kennywakaba/IGEN-430-Minesweeper/mainboard.step

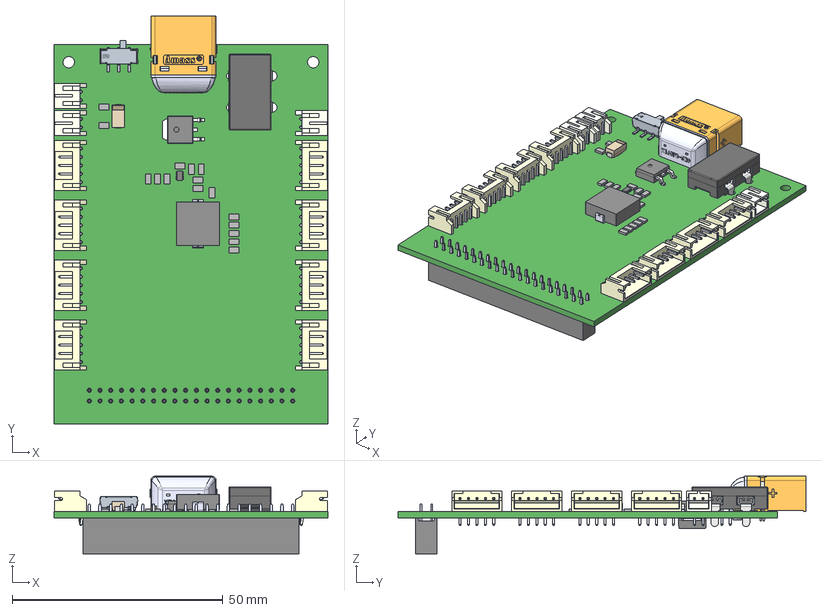
[picture p1: CAD file, 2024-03-06]
mainboard.step
65.0 x 96.8 x 18.5 mm
Extruded x 16
JS102011SAQN--3DModel-Eagle-1
DPAK x 2
keystone-PN3549-2
User Library-XT60PW 3D DRAWING_XT60____-8______-UL-21156
User Library-XT60PW 3D DRAWING_XT60____-8____-21157 x 2
User Library-XT60PW 3D DRAWING_XT60____-8________ x 2
User Library-XT60PW 3D DRAWING_XT60PW-M20____-8-UL
2 row tin body_20
2 row tin pins x 20
