kennywakaba/IGEN-430-Minesweeper/Project Outputs for minesweeper-mainboard/jlc-fabrication.PDF

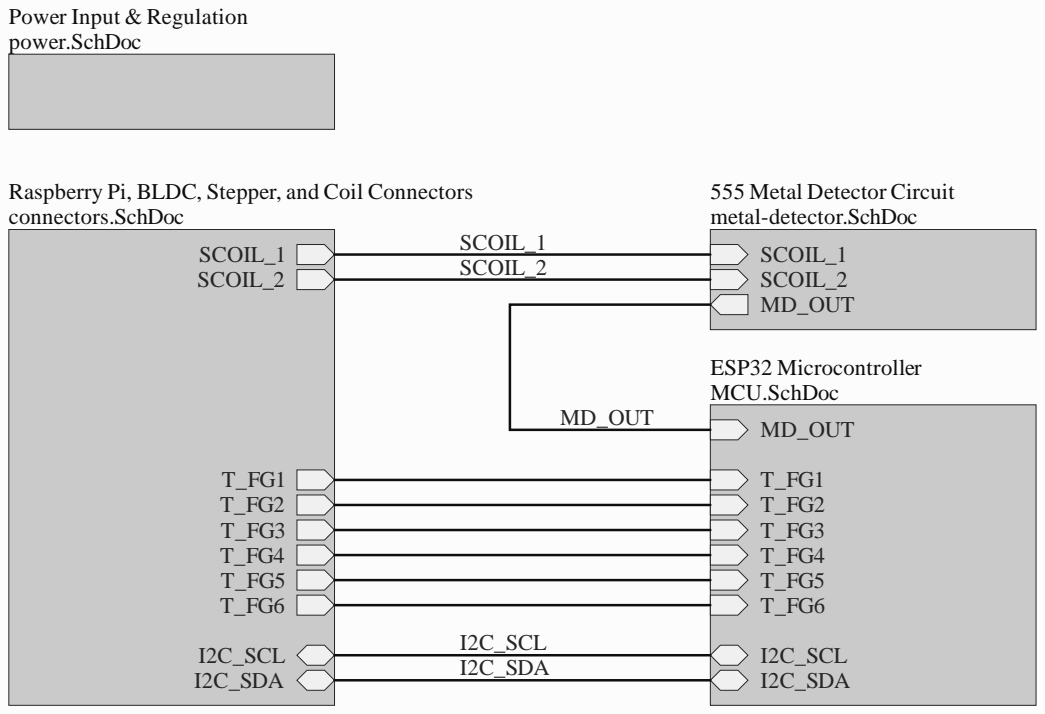
[picture p2: page 1]

Raspberry Pi, BLDC, Stepper, and Coil Connectors
connectors.SchDoc

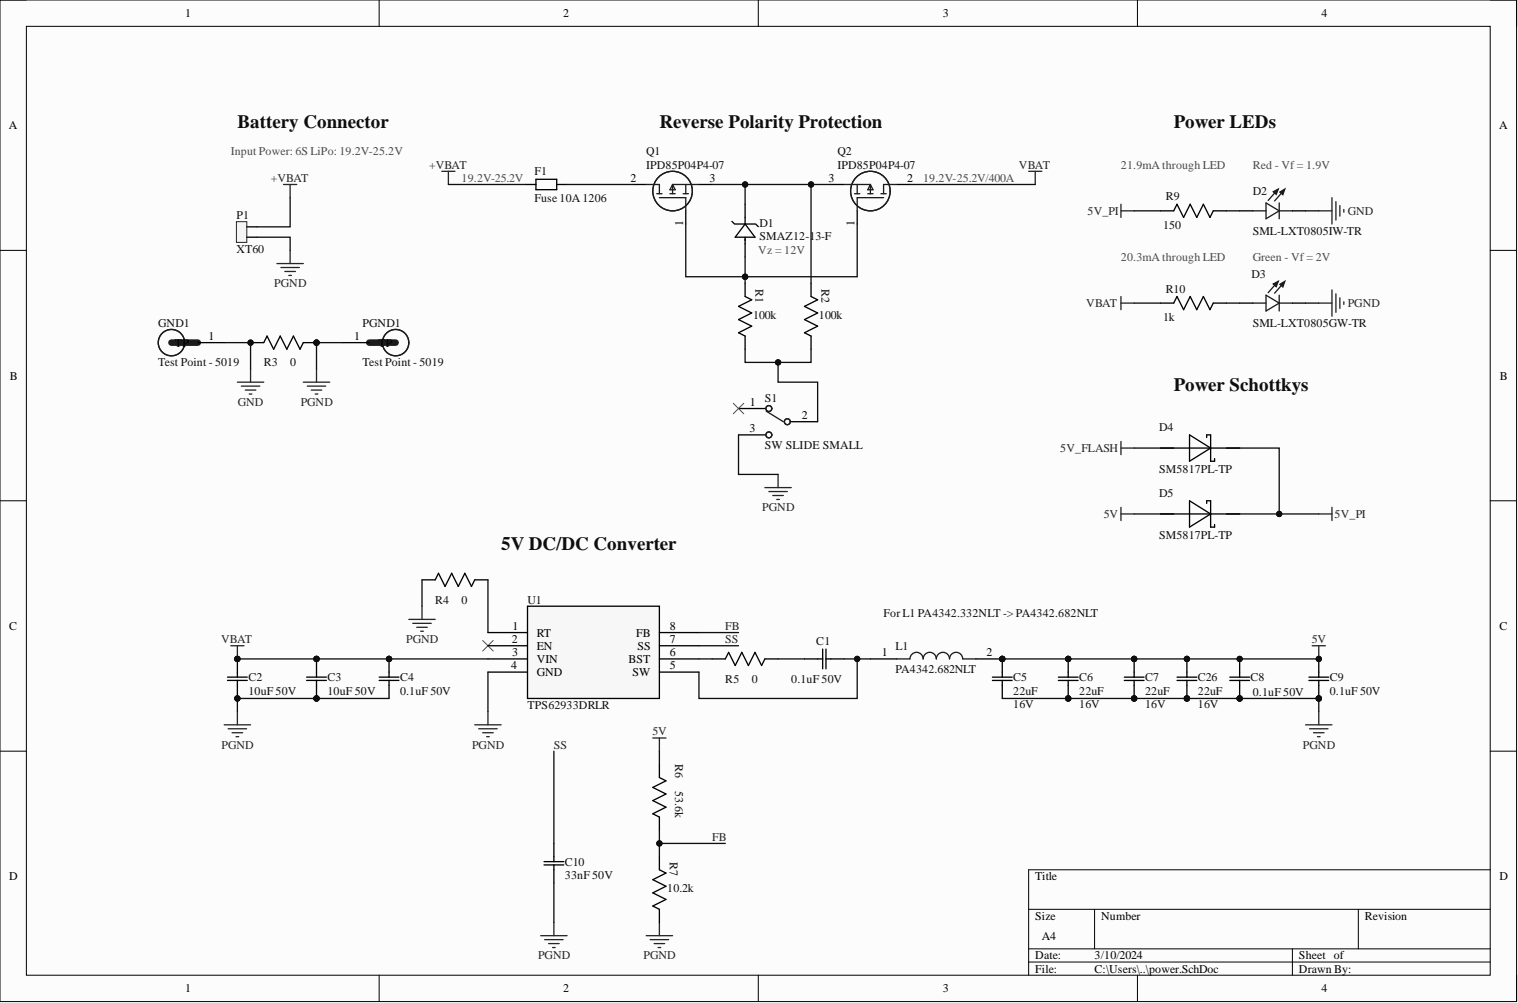
[picture p3: page 2]

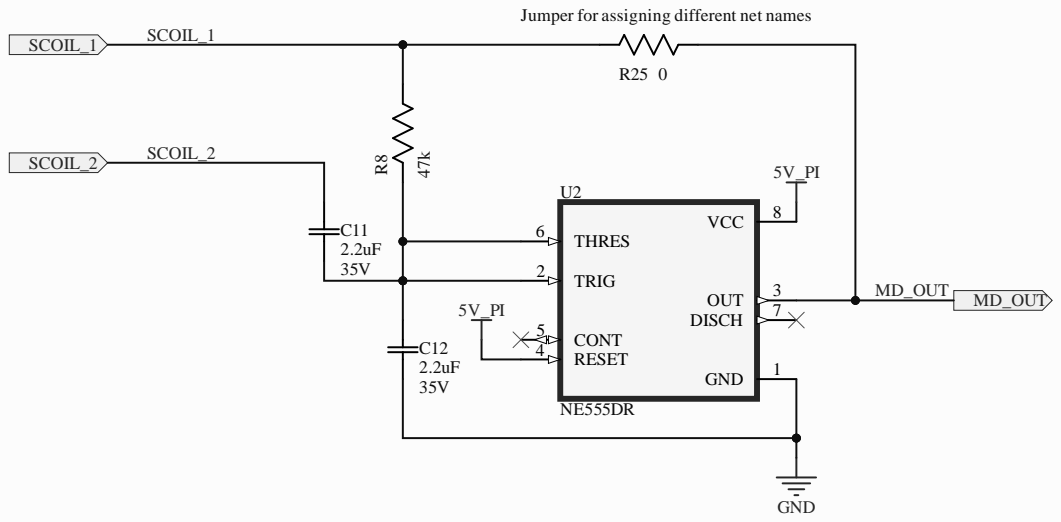
[picture p4: page 3]

DISC CO N T RESE T | H

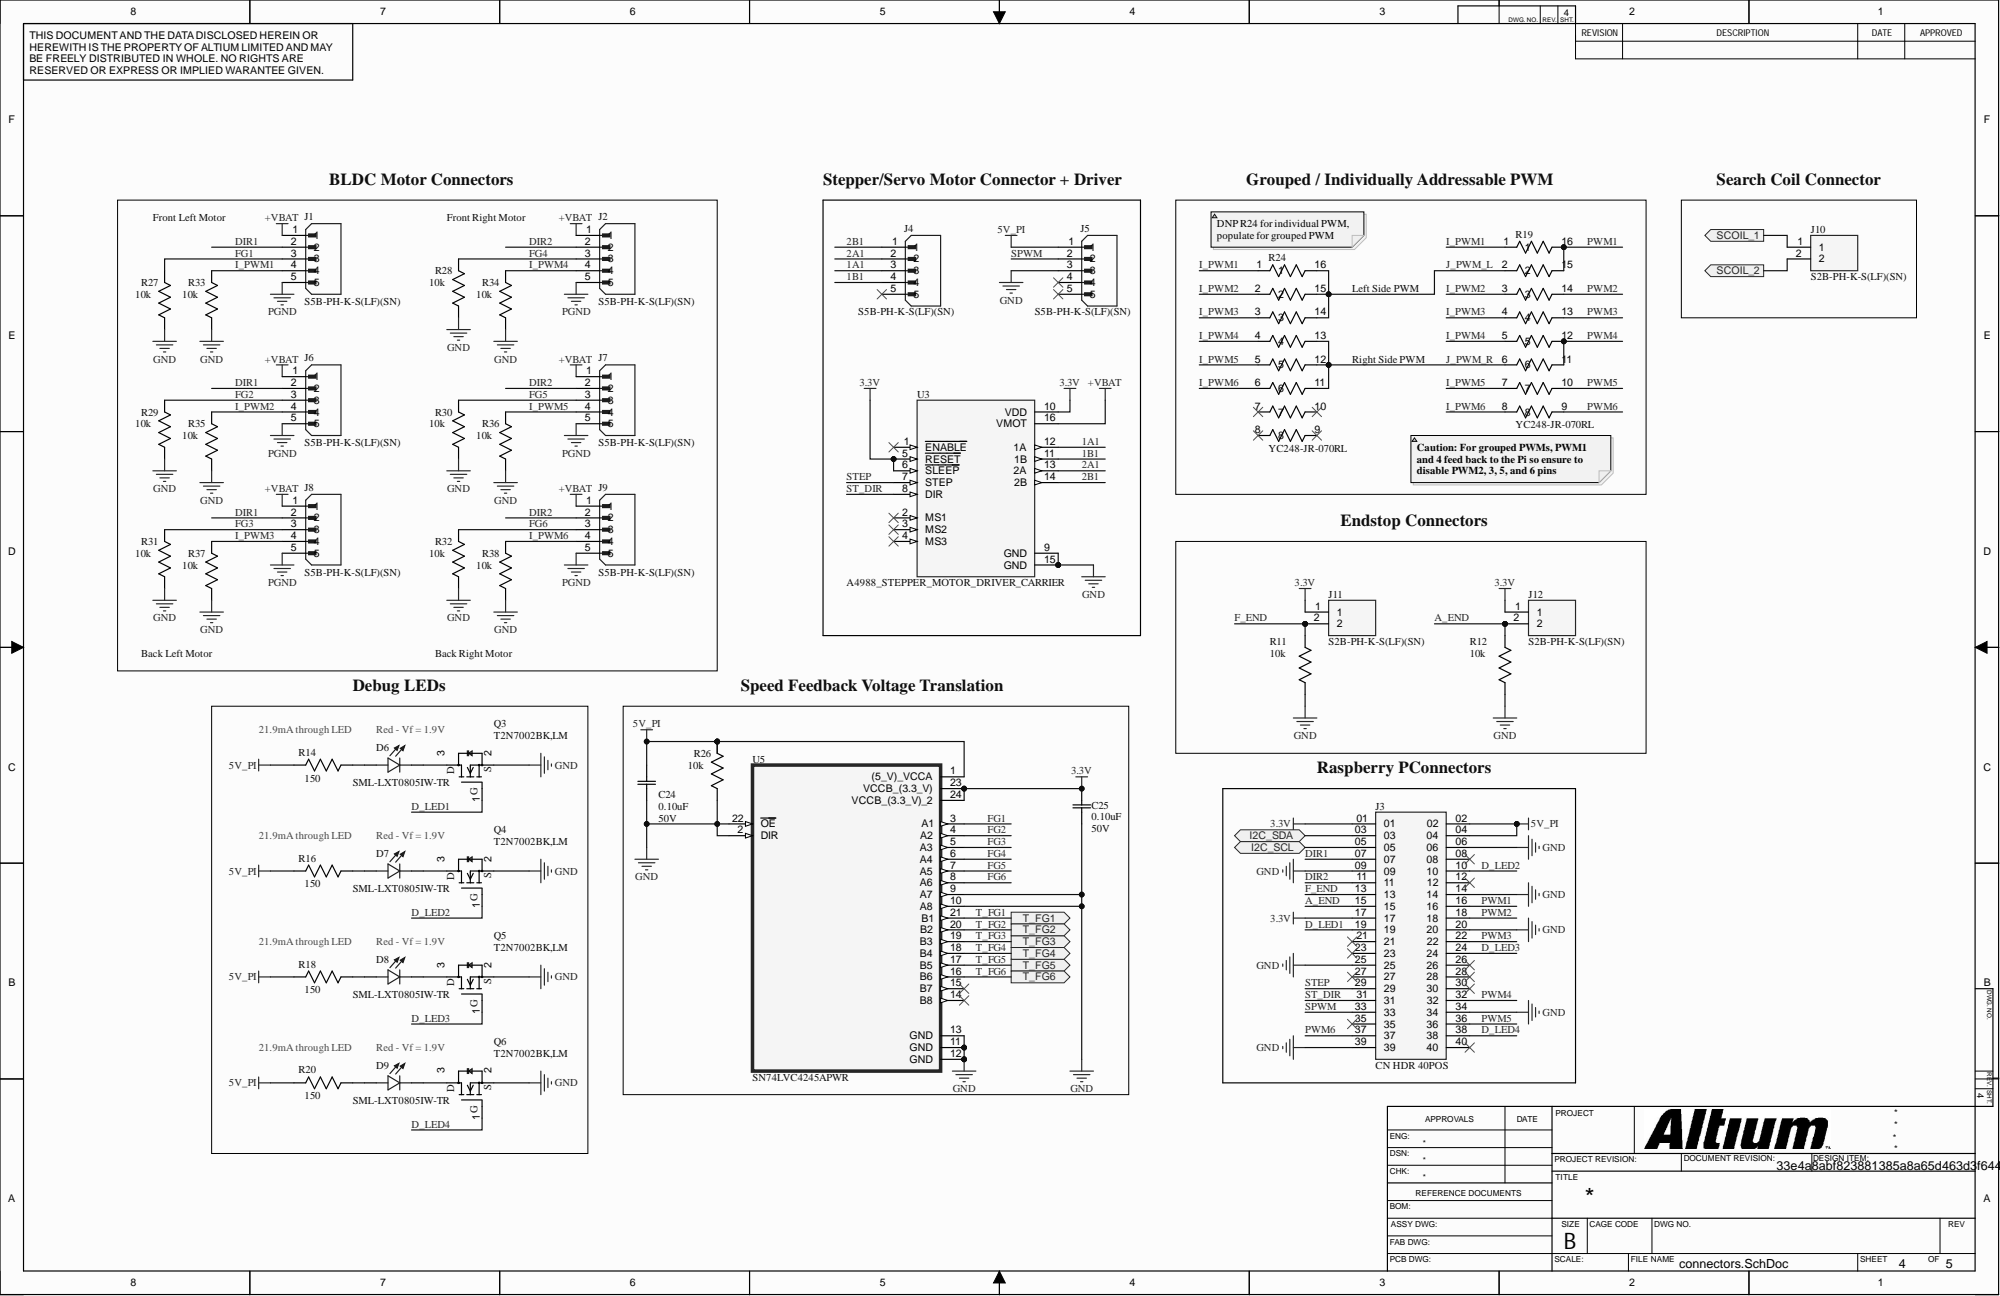
[picture p5: page 4]

DWG . N O . | R E V . | S H T.

T H IS DOC U MEN T AN T HE ATA ISCLOSED HEREI N OR HEREW I T H IS T HE PROPER TY OF ALT I U M LI M I TED AN M AY BE F REELY IST R IBU TED I N W HOLE. NO R IGH TS ARE RESERVED OR EXPRESS OR I MPLIED WARAN TEE GIVEN . BLDC Moto | r Connectors Stepper/Serv o Moto r Connecto r + Driver G r ouped / Individually Addressable PWM | REVISI ON | DESCRIPTI O N | DATE | APPROVED

REV. SHT. DWG. NO.

DATE | PRO JECT | **** APPROVALS

ENG :
** DSN:

CHK: *

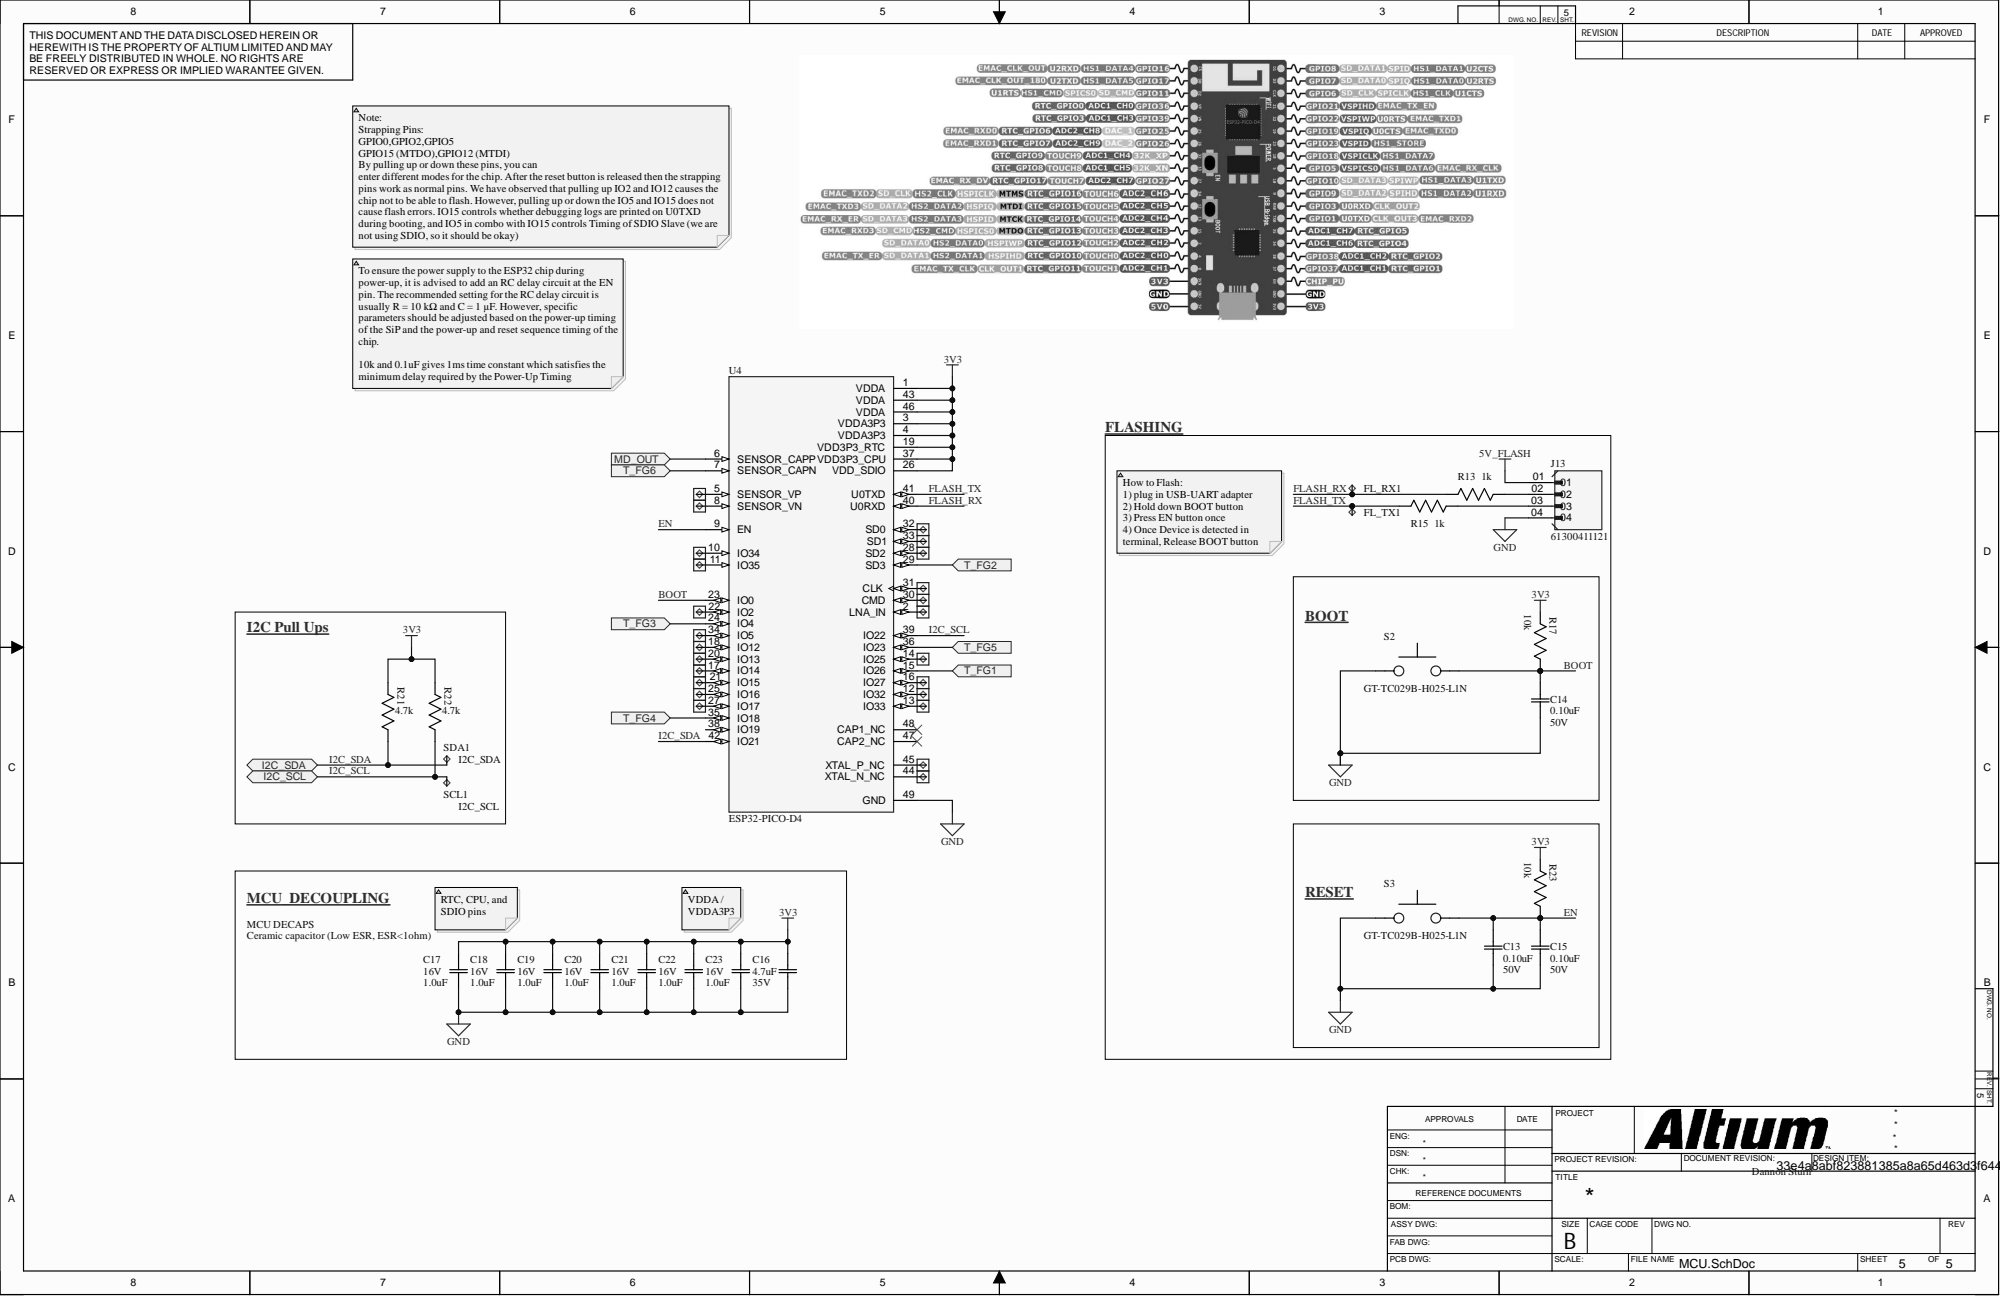
[picture p6: page 5]

DWG . N O . | R E V . | S H T.

T H IS DOC U MEN T AN T HE ATA ISCLOSED HEREI N OR HEREW I T H IS T HE PROPER TY OF ALT I U M LI M I TED AN M AY BE F REELY IST R IBU TED I N W HOLE. NO R IGH TS ARE RESERVED OR EXPRESS OR I MPLIED WARAN TEE GIVEN . | 3 V | REVISI ON | DESCRIPTI O N | DATE | APPROVED

of SDIO Slave (we are

REV. SHT. DWG. NO.

DATE | PRO JECT | **** APPROVALS

ENG :
** DSN:

CHK: *
