kennywakaba/IGEN-430-Minesweeper/simulation/SMAZ12 - Reverse Polarity Protection Circuit/SMAZ12 - Reverse Polarity Protection Circuit.asc

M1: pmos
M2: pmos
R1: res; 100k
R2: res; 100k
R3: res; 1k
U1: SMAZ12
V1: voltage; 23.7
Named nets: 0, VZ+, VZ-
.tran 40u startup
.lib C:\\Users\\kenny\\Downloads\\Zener Diodes.spice.txt
.SUBCKT SMAZ12  1 2
*        Terminals    A   K
D1 1 2 DF
DZ 3 1 DR
VZ 2 3 11.2
.MODEL DF D ( IS=2.51p RS=.0780 N=1.15
+ CJO=100p VJ=0.750 M=0.330 TT=50.1n )
.MODEL DR D ( IS=5.02f RS=0.65 N=1 )
.ENDS
.SIMULATOR DEFAULT
