kennywakaba/IGEN-430-Minesweeper/(list of files, drawings)

Other design files:
components/826949-4/826949-4.PcbLib
components/826949-4/826949-4.SchLib
components/61300411121/61300411121.SchLib
components/61300411121/WURTH_61300411121.PcbLib
components/GT-TC029B-H025-L1N/GT-TC029B-H025-L1N.SchLib
components/NE555DR/NE555DR.SchLib
components/NE555DR/SOIC127P599X175-8N.PcbLib
components/S5B-PH-K-S_LF__SN_/JST_S5B-PH-K-S(LF)(SN).PcbLib
components/S5B-PH-K-S_LF__SN_/Project Outputs for S5B-PH-K-S_LF__SN_/S5B-PH-K-S_LF__SN_/JST_S5B-PH-K-S(LF)(SN).PcbLib
components/S5B-PH-K-S_LF__SN_/Project Outputs for S5B-PH-K-S_LF__SN_/S5B-PH-K-S_LF__SN_/S5B-PH-K-S(LF)(SN).SchLib
components/S5B-PH-K-S_LF__SN_/S5B-PH-K-S(LF)(SN).SchLib
connectors.SchDoc
mainboard.PcbDoc
MCU.SchDoc
metal-detector.SchDoc
minesweeper-mainboard.PrjPcb
power.SchDoc
root.SchDoc
simulation/SMAZ12 - Reverse Polarity Protection Circuit/TPS62932_TRANS.DSN
simulation/SMAZ12 - Reverse Polarity Protection Circuit/TPS62932_TRANS.opj
simulation/SMAZ12 - Reverse Polarity Protection Circuit/TPS62932DRL_TRANS.OLB
