kennywakaba/IGEN-430-Minesweeper/(commit log)

2024-01-18 added root and power schematics
    [minesweeper-mainboard.PrjPcb, power.SchDoc, root.SchDoc]
2024-02-01 added databases and intlib for converter IC. Still need to find footprint for the inductor
    [power.SchDoc]
2024-02-05 completed most of the schematics, waiting on Software regarding Raspberry Pi pinouts and final revision before layout
    [mainboard.PcbDoc, metal-detector.SchDoc, minesweeper-mainboard.PrjPcb, power.SchDoc, root.SchDoc]
2024-02-07 forgot to add connector.SchDoc lol
    [connectors.SchDoc]
2024-03-01 added component folder, layout WIP almost complete, schematic needs an update, look into connectors for endstops
    [connectors.SchDoc, mainboard.PcbDoc, mainboard.step, minesweeper-mainboard.PrjPcb, power.SchDoc]
2024-03-02 added LED circuits, TODO: add 2 pin JSTs, find 5 pin JSTs with preassembled cables, look into ESP32 options
    [mainboard.PcbDoc, power.SchDoc]
2024-03-03 changed connectors to JSTs, added MCU schematic. TODO: add a thermal relief layout, add voltage translater, figure out ESP32 pinouts
    [826949-4.PcbLib, 826949-4.SchLib, MCU.SchDoc, connectors.SchDoc, mainboard.PcbDoc, minesweeper-mainboard.PrjPcb, root.SchDoc]
2024-03-06 added new MCU schematic: WIP
    [MCU.SchDoc, connectors.SchDoc, mainboard.PcbDoc, mainboard.step, minesweeper-mainboard.PrjPcb, power.SchDoc, root.SchDoc]
2024-03-08 added new components, schematic need final revision before layout, check with JLCPCB part stocks afterward
    [61300411121.SchLib, Bill of Materials-minesweeper-mainboard.xlsx, JST_S5B-PH-K-S(LF)(SN).PcbLib, MCU.SchDoc, S5B-PH-K-S(LF)(SN).SchLib, WURTH_61300411121.PcbLib, connectors.SchDoc, mainboard.PcbDoc]
2024-03-09 schematic review in progress, on connector.SchDoc last, added components
    [Bill of Materials-minesweeper-mainboard.xlsx, MCU.SchDoc, connectors.SchDoc, power.SchDoc]
2024-03-10 fixed schematic, layout WIP almost done
    [Bill of Materials-minesweeper-mainboard.csv, Bill of Materials-minesweeper-mainboard.xlsx, GT-TC029B-H025-L1N.SchLib, MCU.SchDoc, TPS62932DRL_TRANS.OLB, TPS62932_TRANS.DSN, TPS62932_TRANS.opj, connectors.SchDoc]
2024-03-10 completed layout, cleaning up silkscreens and deal with verification report, give it 1 more review and get ready for manufacturing
    [connectors.SchDoc, minesweeper-mainboard.PrjPcb]
2024-03-11 completed schematic + layout, generated production files
    [Bill of Materials-minesweeper-mainboard.xlsx, MCU.SchDoc, NE555DR.SchLib, Pick Place for mainboard.csv, SOIC127P599X175-8N.PcbLib, connectors.SchDoc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]
